pachobg2/moskvich_ignition/README.md

# moskvich_ignition — programmable ignition ECU for the Moskvich 412 / 2140

ESP32-C3 replaces the points-and-coil ignition's *switching* job while keeping
the original distributor. The points become a crank-position sensor, the ECU
fires the coil through an IGBT at a timing it looks up from an **rpm × MAP
map**, controls dwell from battery voltage, trims idle speed with spark
timing, and limits revs. Everything is tuned from a phone over the ECU's own
WiFi network — no app to install, no router needed.

> **Experimental, safety-relevant.** Wrong spark timing can wreck an engine,
> and a dead ECU means a dead engine (see *Limitations*). Bench-test with the
> simulator, verify timing with a timing light before every first start, and
> start from the conservative default map.

## How it works

```
 12 V switched ──┬── protection + buck ──► ESP32-C3 ──► gate ──► IGBT ──► coil (−)
                 │                           ▲  ▲
 distributor ────┼── pull-up + NPN ──────────┘  │ ADC
   (points)      │                              │
 MAP hose ───────┴── MPX4115-class sensor ──────┘
```

* **Trigger reference (Setup):** two choices.
  **OPEN edge (default)** — distributor locked at full advance, trigger ≈ 40°: most accurate.
  **CLOSE edge** — factory distributor (weights blocked at rest, vacuum capsule off), trigger ≈ 120°
  before the firing cylinder: the ECU predicts ~3× further ahead (use *Acceleration compensation*
  100%, which the UI sets for you), and while cranking it falls back to the OPEN edge (≈10° factory
  static timing) because 120° of prediction is far too coarse at cranking-speed variation.
  Host-simulated error: ≤0.04° steady, ~0.9° over a 1000→5500 rpm/4 s ramp, ≤0.5° on a hard
  lift-off with compensation, ≈0.3° cranking. The closing edge bounces more than the opening one:
  verify on a scope.
* **Points = sensor only.** They no longer carry coil current (no arcing, no
  condenser needed). The instant they *open* marks a fixed crank angle,
  `trigger angle` (≈ 40° BTDC).
* **The distributor's mechanical advance is locked at that angle** (weights
  blocked, vacuum capsule disconnected). The ECU can only *delay* the spark
  relative to the trigger, so any advance up to the trigger angle is
  available:
  `delay = (trigger − target advance) / 180° × time since last trigger`.
* **Dwell** is ECU-controlled and voltage-compensated: at idle/cranking the
  coil is switched on `delay − dwell` after the trigger (exact dwell); at
  higher rpm it is scheduled one cycle ahead from the measured period.
* **Timing map**: 16 rpm × 16 MAP bins, bilinear interpolation, ± idle trim,
  rev-limit retard, slew limit per spark, min/max clamps.
* **LPG**: a 12 V signal from the LPG valve (GPIO3 via divider) switches the
  timing. Two modes (LPG tab): **static offset** (petrol map + N degrees,
  default +3°; no map is shown) or a **separate LPG map** (edited on the LPG tab, with
  *Copy petrol → LPG* and an optional offset). The change is slewed in at the normal per-spark limit,
  never stepped. A *Force petrol / Force LPG* override in Setup helps testing without
  the valve connected (LPG tab).
* **Factory-derived maps (Map tab → "Ignition map")**: besides your *Custom* map there are three
  slots built from the distributor data tables of the UZAM-412 family — **P-147A**, **47.3706**,
  **P-147B** — so the engine can run on a replica of the original advance curve and you can tune from there.
  Total advance = static timing + centrifugal(rpm) + vacuum(MAP) × fade(rpm), using the data-sheet
  centrifugal points (1000–5000 rpm) and the vacuum-capsule points (mmHg). Assumptions: the static
  timing is 10° (editable, "Regenerate"); the tables are in crank degrees; vacuum = 101.3 kPa − MAP;
  the capsule's tolerance bands are used at their middle; the capsule is fed from a *ported* carburettor
  vacuum that is ~0 at idle, so the vacuum advance fades in between 900 and 1300 rpm; centrifugal advance
  starts at 600 rpm and stays at its 5000 rpm value above that. **The curves reach 50–60°**, so the
  trigger angle and *Maximum advance* must allow it (the CLOSE-edge reference at ≈120° does; a 30–40° trigger
  clips them — the app shows how many cells are clipped and hatches them). You can edit a factory slot;
  *Regenerate* restores its factory curve and *Copy to Custom* starts a tune from it.
* **Cranking** uses a fixed retarded advance below `crank rpm`.
* **Rev limiter**: retard ramp from the soft limit, spark cut above the hard limit.
* **Idle control**: PI loop that nudges timing to hold the target idle rpm
  while the throttle is closed (MAP below a threshold).
* **Ignition ISRs run at interrupt priority 3**, above WiFi, so tuning on a
  phone does not move the spark. Flash writes (saving, OTA) *do* stall them,
  so the ECU **refuses to write flash while the engine turns** — edits apply
  live and are saved when you press Save with the engine stopped, or
  automatically when it stops.
* Hardware safeguards in firmware: coil-on watchdog (9 ms) if no spark was
  scheduled, no spark without a valid period measurement, bounce rejection,
  all inputs from the web app clamped by `sanitize()`.

## Files

| File | Purpose |
|---|---|
| `moskvich_ignition.ino` | setup/loop: ADC sampling, idle PI, LED, WiFi AP, OTA |
| `ignition_core.h` | **all ignition math & scheduling** — pure C++, no Arduino; tested on a PC |
| `ecu_engine.h` | ESP32-C3 layer: GPIO ISR, two one-shot hardware timers, bench simulator |
| `ecu_store.h` | NVS persistence (checksummed) and parameter `sanitize()` |
| `ecu_web.h` | web server + JSON API |
| `web/index.html` | the tuning app (single file, no dependencies; add `?mock` to try it on a PC) |
| `web_ui.h` | generated from `web/index.html` by `python tools/embed_ui.py` |
| `test/test_core.cpp` | engine-model simulation of the real ISR logic |
| `config.h.example` | copy to `config.h`: AP/OTA passwords, pins, sensor constants (gitignored) |
| `docs/HARDWARE.md` | circuit, parts list, wiring, install & tuning procedure |
| `hardware/` | **schematic, PCB (KiCad), BOM** — through-hole, ESP32-C3-Zero, IGBT cut-out; see `hardware/README.md` |

## Build

Arduino IDE / arduino-cli, **esp32 core 3.x**, board *ESP32C3 Dev Module*
(*USB CDC On Boot: Enabled* for the SuperMini), library **ArduinoJson 7**.

```bash
arduino-cli compile --fqbn esp32:esp32:esp32c3:CDCOnBoot=cdc .
```

Copy `config.h.example` → `config.h` and set the passwords. After editing
`web/index.html` run `python tools/embed_ui.py`.

Host tests (any C++17 compiler):

```bash
c++ -O2 -std=c++17 -I. test/test_core.cpp -o test/test_core && ./test/test_core
```

## Using it

1. Join WiFi **Moskvich-ECU** (password from `config.h`); the app opens as a
   captive portal, or browse to `http://192.168.4.1`.
2. **Live** — rpm, advance, MAP, battery, dwell, 60 s chart.
3. **Map** — petrol map: tap cells, ±0.5/±1, Set, Smooth, Range select, Undo, editable axes.
   The cells around the current operating point glow while the engine runs.
4. **Setup** — trigger angle, cranking, idle, limits, dwell table, MAP sensor two-point calibration.
   **LPG** — mode, static offset or the separate LPG map, valve-signal status, override.
5. **Language** — the **БГ / EN** button in the header switches the whole interface between Bulgarian and English (remembered per browser; `?lang=bg` in the URL also works). The default follows the browser language. Translations live in the `BG` table in `web/index.html`; the firmware-upload page is bilingual.
6. **Tools** — timing-light lock, bench simulator, JSON backup/restore, reset, firmware update.

Install, wiring and the timing-light calibration procedure are in
[docs/HARDWARE.md](docs/HARDWARE.md).

## Limitations / ideas

* **No limp-home.** With advance locked at 40°, running the stock points
  circuit would kick back on starting, so there is no relay bypass. Carry a
  spare ECU or the original distributor internals.
* No cam/phase signal: cylinder-to-cylinder cam-lobe and bushing wear shows up as
  a few degrees of scatter that the ECU cannot correct. A Hall-effect or
  optical distributor conversion would use the same input (set the edge).
* No knock sensor, no coolant/air temperature correction (spare ADC pins exist).
* ISR jitter vs. WiFi has been reasoned about, not scope-measured: verify with a
  scope/timing light at 6000 rpm on the bench simulator and adjust `latency_us`.
* Idea: log a short ring buffer of rpm/MAP/advance for download after a drive.

## Version History

| Version | Date | Changes |
|---|---|---|
| 1.0.0 | 2026-10-26 | Initial release: points-trigger delay-only timing, 16×16 rpm×MAP map, voltage-compensated dwell, cranking/idle/rev-limit logic, WiFi AP web tuner (live data, map editor, setup, timing-light lock, bench simulator, backup, OTA), host-side engine-model tests. |
| 1.1.0 | 2026-10-27 | MAP sensor two-point calibration in Setup (any linear 1-bar analog sensor, e.g. GM/Lada/Bosch; capture-from-live-reading buttons); `MAP_SLOPE`/`MAP_OFFSET`/`MAP_SUPPLY_MV` removed from `config.h`. Stored settings from 1.0.0 are discarded on first boot (defaults load). |
| 1.2.0 | 2026-10-27 | LPG timing: 12 V valve-signal input (GPIO3, hysteresis + debounce), static-offset mode or separate LPG map, copy petrol → LPG (+offset), manual override, LPG badge in the UI. Settings from 1.1.0 are discarded on first boot (defaults load). |
| 1.2.1 | 2026-10-27 | UI: LPG settings moved to their own tab; the LPG map is only shown in "Separate LPG map" mode (static-offset mode shows just the offset). |
| 1.3.0 | 2026-10-27 | Setup: choice of trigger reference — points OPEN edge (distributor locked at full advance, ~40°) or points CLOSE edge (factory distributor, ~120°) with automatic OPEN-edge cranking reference; trigger angle range up to 160°; extended host tests. Settings from 1.2.x are discarded on first boot (defaults load). |
| 1.4.0 | 2026-10-27 | Web interface available in Bulgarian (БГ/EN switch, default from browser language), bilingual firmware-upload page; fix: elements marked hidden (e.g. the LPG copy button on the petrol map) were still shown. |
| 1.4.1 | 2026-10-27 | UI: hover tooltips (in both languages) on every setting and control, e.g. what Gain (P) and Gain (I) do; the web page is now stored gzip-compressed (flash use 92% -> 88%). |
| 1.5.0 | 2026-10-27 | Targets the ESP32-C3-Zero board (new PCB in `hardware/`): pins LPG 0 / MAP 1 / VBAT 3 / POINTS 4 / COIL 6, status shown on the on-board RGB LED (GPIO10). |
| 1.6.0 | 2026-10-28 | Three factory-derived petrol maps (P-147A, 47.3706, P-147B) selectable in the Map tab, built from the UZAM-412 distributor centrifugal + vacuum advance tables; regenerate / copy-to-custom; map cells may exceed the trigger angle (clipped at use, shown in the UI). Settings from 1.5.0 are discarded on first boot (defaults load). |
| 1.6.1 | 2026-10-28 | UI: switching the trigger reference to CLOSE edge now also raises Maximum advance to 60° (it was still capping the map at 38°); the "cells exceed the limit" warning names the limit that is binding (Maximum advance or Trigger angle) and where to change it. |
| 1.6.2 | 2026-10-28 | Safety: firmware updates are refused while the engine runs (a bare POST to /update no longer reboots the ECU, and ArduinoOTA is not serviced while running); /update reports OK only after a completed upload. |
