pachobg2/moskvich_ignition/hardware/netlist.csv

Net | Pins
+12V_IN | J1.2 F1.2
+3V3 | U1.3 R4.2
+5V | U1.1 J2.2 U2.1 L1.2 C3.1 C4.1 U3.9 U3.16 C9.1 R14.2
BST | U2.6 C11.1
CEXT | U3.14 C10.1
CMD | U3.2 U3.3 R10.2 R13.1
CMD_G | U1.10 R10.1
COIL_N | J1.4 Q1.2
GATE | Q1.1 R15.1 R16.1
GATE_DRV | U3.13 R15.2
GND | U1.2 J2.4 J1.3 Q1.3 U2.4 C3.2 C4.2 C1.2 C2.2 D2.2 R7.2 C6.2 D4.2 R9.2 C7.2 D5.2 R12.2 C8.2 D6.2 R3.2 D3.2 Q2.2 C5.1 U3.1 U3.8 U3.10 U3.11 R13.2 C9.2 R16.2
LPG_IN | J2.1 R6.1
LPG_S | U1.4 R6.2 R7.1 C6.1 D4.1
MAP_S | U1.5 R11.2 R12.1 C8.1 D6.1
MAP_SIG | J2.3 R11.1
POINTS_RAW | J1.1 R1.2 R2.1
PT_B | R2.2 R3.1 D3.1 Q2.1
PT_C | Q2.3 R4.1 R5.1
PT_G | U1.8 R5.2 C5.2
REXT | U3.15 R14.1 C10.2
SW | U2.5 L1.1 C11.2
VBAT_F | D1.2 F1.1 R8.1
VB_S | U1.7 R8.2 R9.1 C7.1 D5.1
VIN_P | U2.2 U2.3 C1.1 C2.1 D2.1 D1.1 R1.1
