pachobg2/moskvich_ignition/hardware/bom.csv

Qty | Refs | Value | Footprint | Description
1 | C1 | 10uF 50V | C_1210 | Capacitor 1210 X7R 10 uF 50 V
1 | C10 | 2.2uF 25V X7R | C_0805 | Capacitor 0805 X5R/X7R (22 uF >= 10 V, 2.2 uF >= 25 V)
6 | C11 C2 C6 C7 C8 C9 | 100nF | C_0603 | Capacitor 0603 X7R 50 V
2 | C3 C4 | 22uF 10V | C_0805 | Capacitor 0805 X5R/X7R (22 uF >= 10 V, 2.2 uF >= 25 V)
1 | C5 | 10nF | C_0603 | Capacitor 0603 X7R 50 V
1 | D1 | SS34 | D_SMA | Schottky SMA (pin 1 = cathode)
1 | D2 | SMBJ24A | D_SMB | TVS SMB, unidirectional (pin 1 = cathode)
1 | D3 | 1N4148W | D_SOD-123 | SOD-123 diode (pin 1 = cathode)
3 | D4 D5 D6 | BZT52C3V6 | D_SOD-123 | SOD-123 diode (pin 1 = cathode)
1 | F1 | 0.5A 32V fuse | Fuse_1206 | SMD fuse 0.5 A, rated >= 32 V (1206 / 2410), or a resettable PTC of the same footprint
3 | H1 H2 H3 | M2.5 mounting hole (6 mm standoff) | MountingHole_2.7_M2.5 | M2.5 screw + 6 mm standoff
1 | J1 | Power | TerminalBlock_P3.50_1x04 | Screw terminal 3.5 mm pitch, 4 positions, 8 A
1 | J2 | Sensors | TerminalBlock_P3.50_1x04 | Screw terminal 3.5 mm pitch, 4 positions, 8 A
1 | L1 | 4.7uH | L_4x4 | Shielded power inductor 4.7 uH, 4x4 mm, I_sat >= 2 A, DCR < 100 mOhm (check the land pattern of the part you buy)
1 | Q1 | ISL9V3040P3 | TO-220_LayDown_Cutout | Ignition IGBT ISL9V3040P3 (TO-220), laid flat on the case floor in the cut-out
1 | Q2 | BC847B | SOT-23 | NPN BC847B (1 = B, 2 = E, 3 = C)
1 | R1 | 1k 0.25W | R_1206 | Resistor 1206, 0.25 W
2 | R10 R15 | 100R | R_0603 | Resistor 0603 1 % (thick film)
4 | R11 R13 R16 R2 | 10k | R_0603 | Resistor 0603 1 % (thick film)
2 | R12 R14 | 15k | R_0603 | Resistor 0603 1 % (thick film)
1 | R4 | 4.7k | R_0603 | Resistor 0603 1 % (thick film)
1 | R5 | 1k | R_0603 | Resistor 0603 1 % (thick film)
2 | R6 R8 | 100k | R_0603 | Resistor 0603 1 % (thick film)
3 | R3 R7 R9 | 22k | R_0603 | Resistor 0603 1 % (thick film)
1 | U1 | ESP32-C3-Zero | ESP32-C3-Zero_2x9_Socket | Waveshare ESP32-C3-Zero on 2x 1x9 female headers (2.54 mm, 15.24 mm apart)
1 | U2 | AP63205WU-7 | SOT-23-6 | AP63205WU-7 (TSOT-26): 1 FB, 2 EN, 3 VIN, 4 GND, 5 SW, 6 BST
1 | U3 | CD74HCT221M96 | SOIC-16_3.9x9.9mm_P1.27mm | CD74HCT221M96 (SOIC-16 narrow; same pinout as the 74HCT123). Non-retriggerable, tW = 0.7 Rx Cx
