pachobg2/moskvich_ignition/hardware/moskvich_ecu.kicad_pcb

## KiCad design hardware/moskvich_ecu.kicad_pcb (2026-10-26)

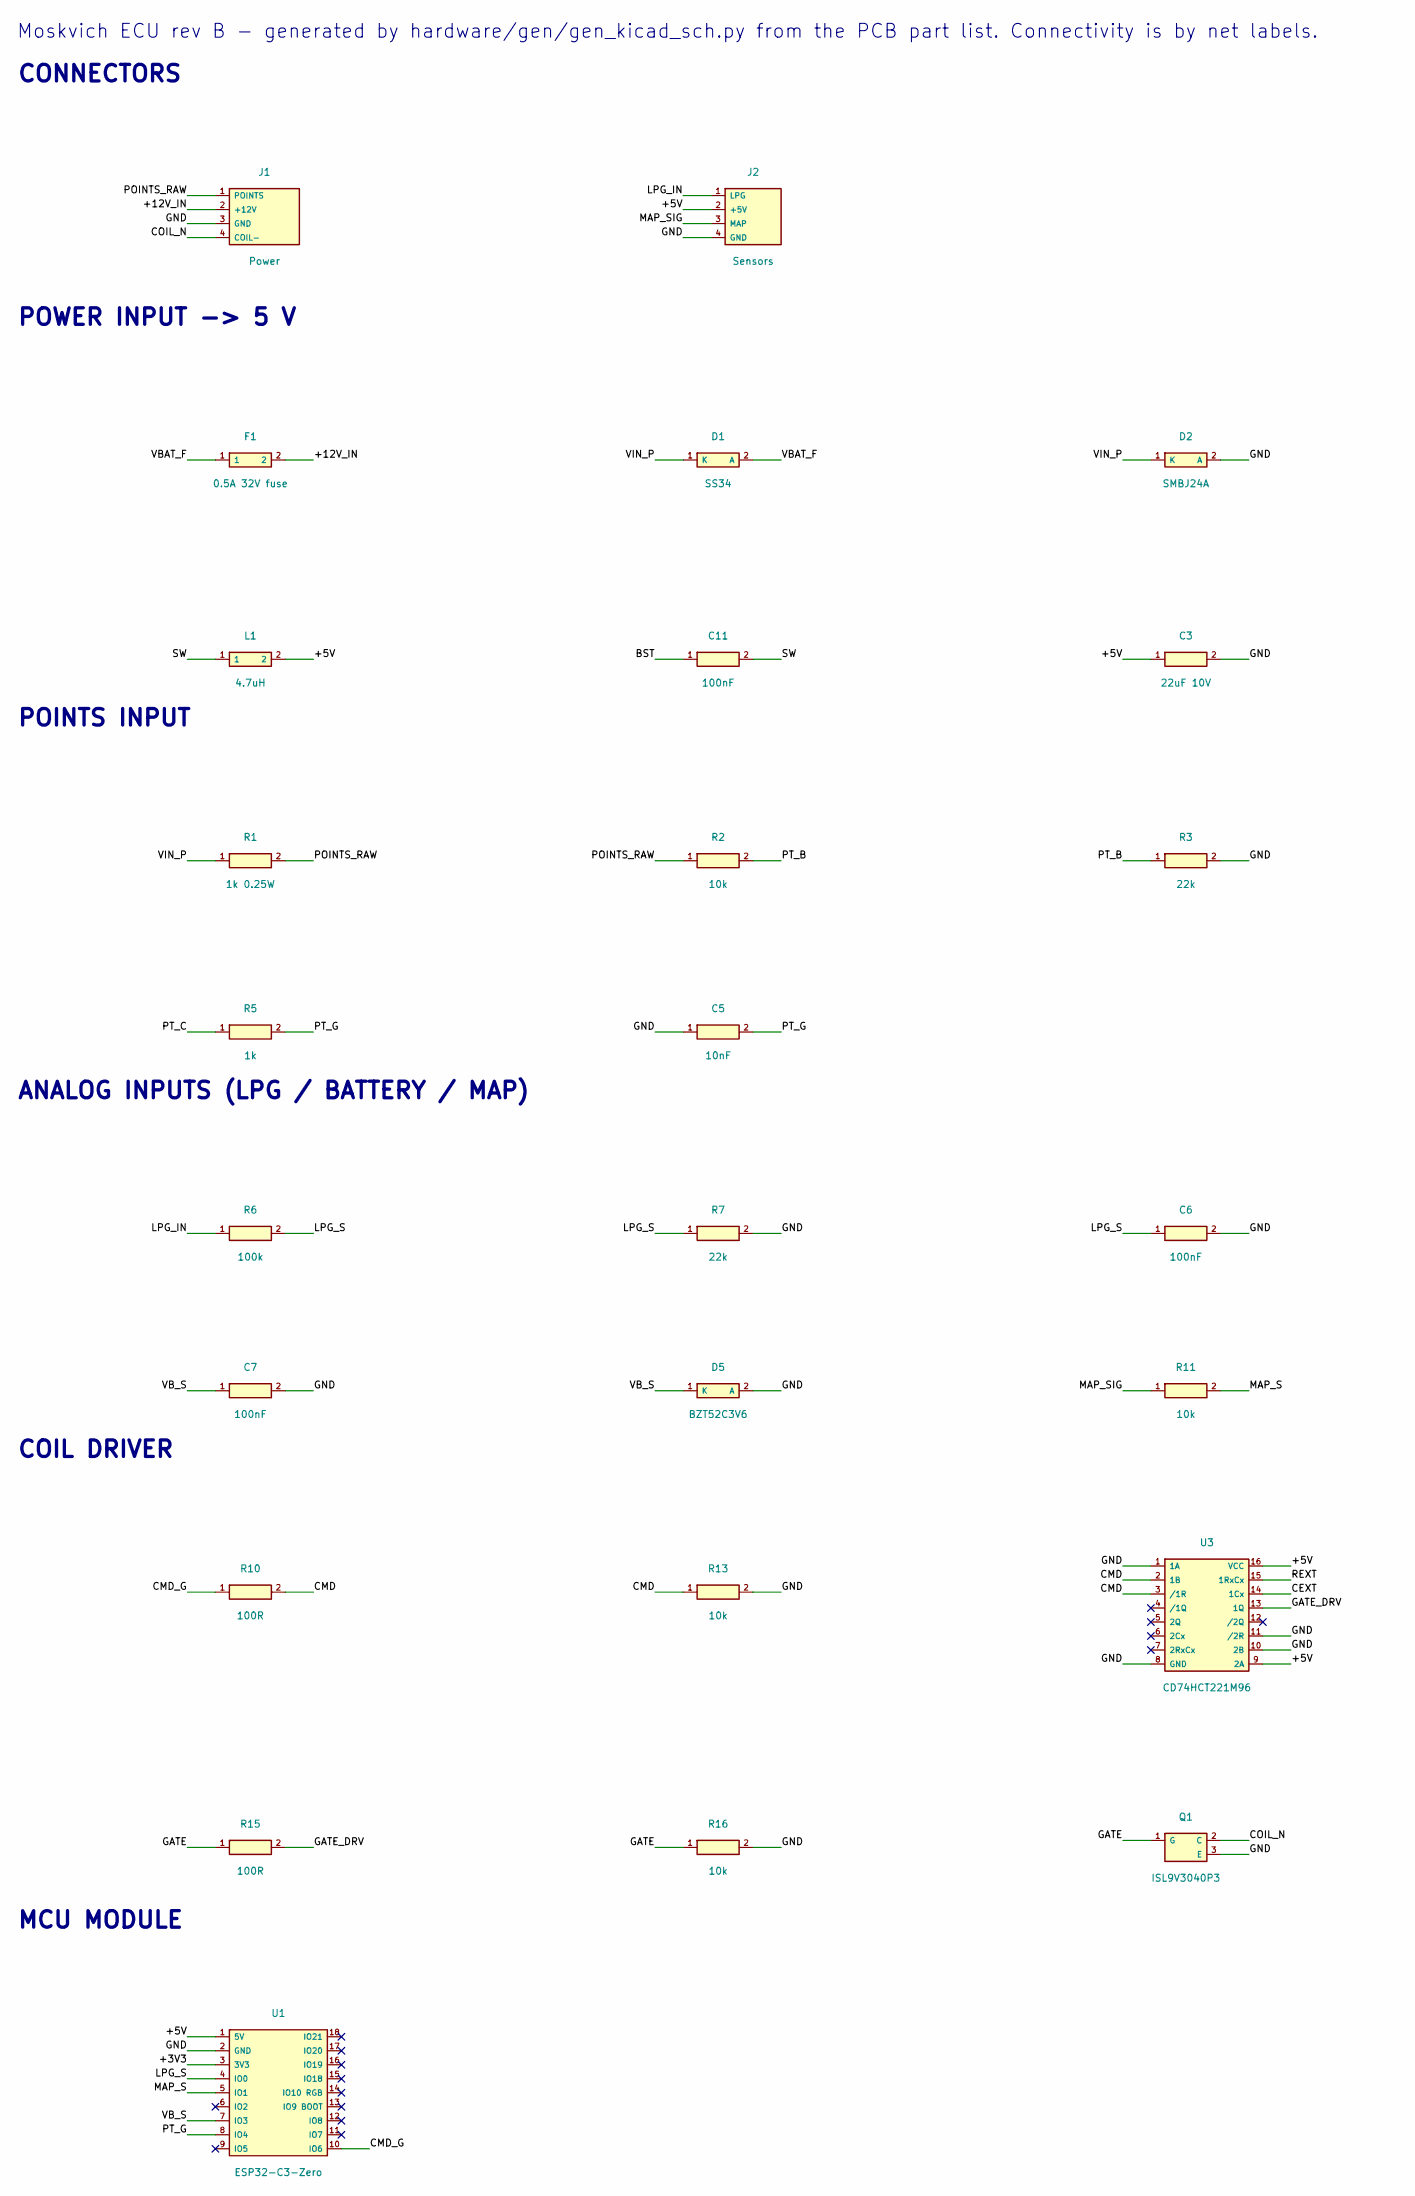
[picture p1: schematic moskvich_ecu.kicad_sch, part in row 1, column 1]

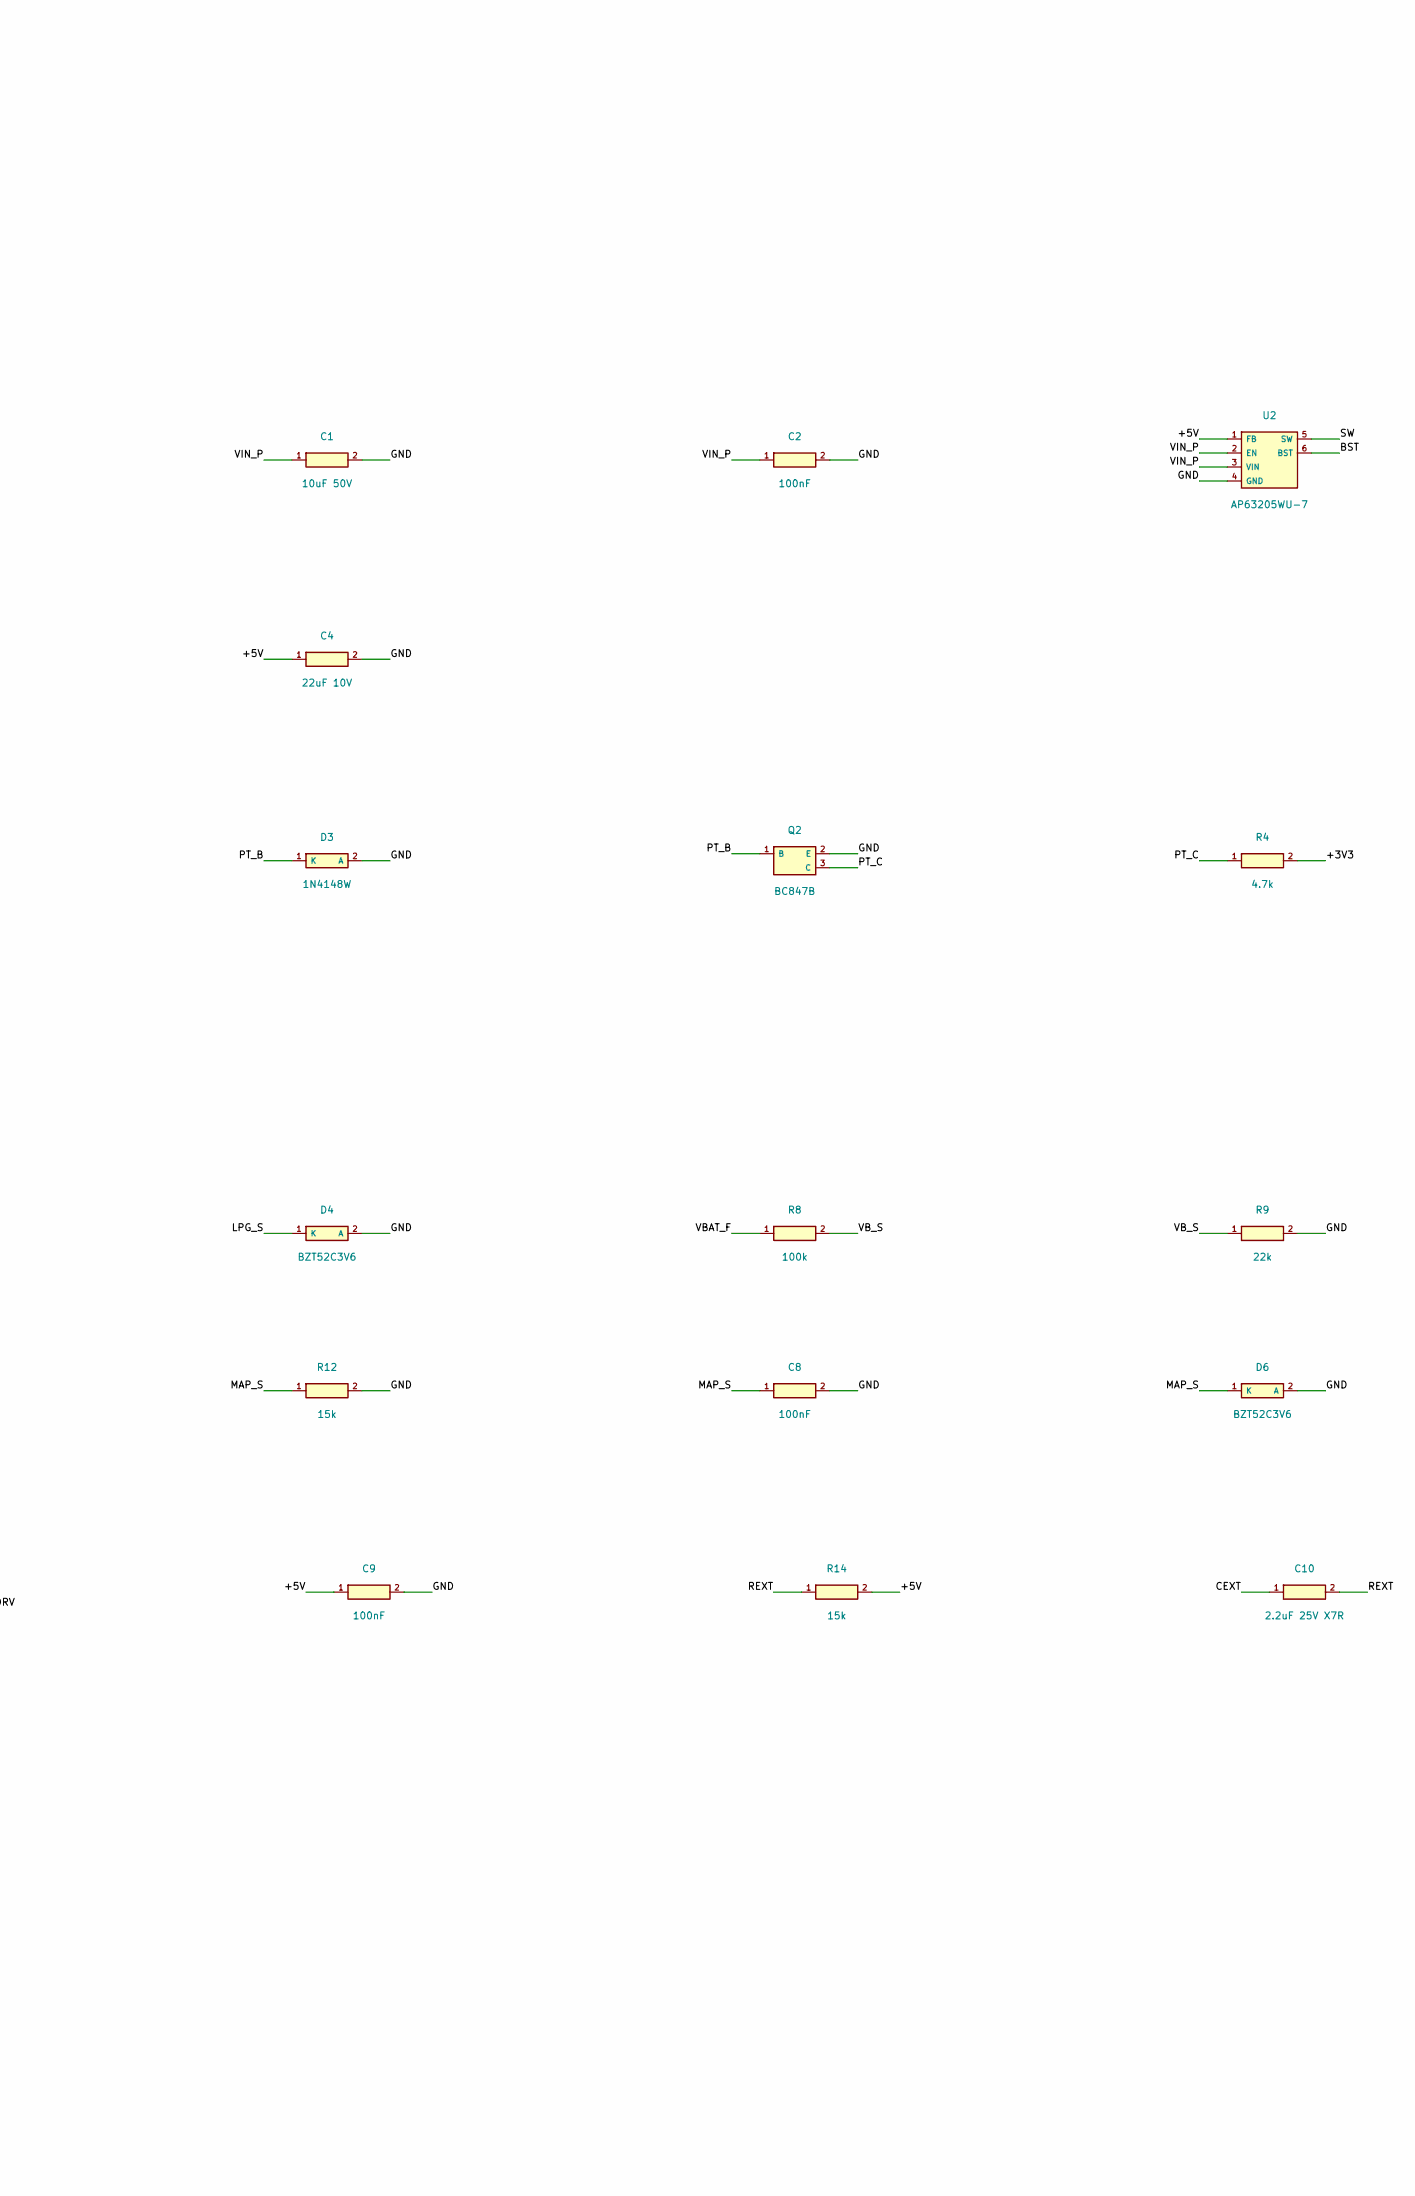
[picture p2: schematic moskvich_ecu.kicad_sch, part in row 1, column 2]

Parts:
C1: 10uF 50V; C_1210_3225Metric
C2, C6, C7, C8, C9, C11: 100nF; C_0603_1608Metric
C3, C4: 22uF 10V; C_0805_2012Metric
C5: 10nF; C_0603_1608Metric
C10: 2.2uF 25V X7R; C_0805_2012Metric
D1: SS34; D_SMA
D2: SMBJ24A; D_SMB
D3: 1N4148W; D_SOD-123
D4, D5, D6: BZT52C3V6; D_SOD-123
F1: 0.5A 32V fuse; Fuse_1206_3216Metric
J1: Power; TerminalBlock_P3.50_1x04
J2: Sensors; TerminalBlock_P3.50_1x04
L1: 4.7uH; pick your inductor)
Q1: ISL9V3040P3; TO-220_LayDown_Cutout
Q2: BC847B; SOT-23
R1: 1k 0.25W; R_1206_3216Metric
R2, R11, R13, R16: 10k; R_0603_1608Metric
R3, R7, R9: 22k; R_0603_1608Metric
R4: 4.7k; R_0603_1608Metric
R5: 1k; R_0603_1608Metric
R6, R8: 100k; R_0603_1608Metric
R10, R15: 100R; R_0603_1608Metric
R12, R14: 15k; R_0603_1608Metric
U1: ESP32-C3-Zero; ESP32-C3-Zero_2x9_Socket
U2: AP63205WU-7; SOT-23-6
U3: CD74HCT221M96; SOIC-16_3.9x9.9mm_P1.27mm

Connections:
+3V3: R4.2, U1.3 (3V3)
+5V: C3.1, C4.1, C9.1, J2.2 (+5V), L1.2, R14.2, U1.1 (5V), U2.1 (FB), U3.9 (2A), U3.16 (VCC)
+12V_IN: F1.2, J1.2 (+12V)
BST: C11.1, U2.6 (BST)
CEXT: C10.1, U3.14 (1Cx)
CMD: R10.2, R13.1, U3.2 (1B), U3.3 (/1R)
CMD_G: R10.1, U1.10 (IO6)
COIL_N: J1.4 (COIL-), Q1.2 (C)
GATE: Q1.1 (G), R15.1, R16.1
GATE_DRV: R15.2, U3.13 (1Q)
GND: C1.2, C2.2, C3.2, C4.2, C5.1, C6.2, C7.2, C8.2, C9.2, D2.2 (A), D3.2 (A), D4.2 (A), D5.2 (A), D6.2 (A), J1.3 (GND), J2.4 (GND), Q1.3 (E), Q2.2 (E), R3.2, R7.2, R9.2, R12.2, R13.2, R16.2, U1.2 (GND), U2.4 (GND), U3.1 (1A), U3.8 (GND), U3.10 (2B), U3.11 (/2R)
LPG_IN: J2.1 (LPG), R6.1
LPG_S: C6.1, D4.1 (K), R6.2, R7.1, U1.4 (IO0)
MAP_S: C8.1, D6.1 (K), R11.2, R12.1, U1.5 (IO1)
MAP_SIG: J2.3 (MAP), R11.1
POINTS_RAW: J1.1 (POINTS), R1.2, R2.1
PT_B: D3.1 (K), Q2.1 (B), R2.2, R3.1
PT_C: Q2.3 (C), R4.1, R5.1
PT_G: C5.2, R5.2, U1.8 (IO4)
REXT: C10.2, R14.1, U3.15 (1RxCx)
SW: C11.2, L1.1, U2.5 (SW)
VBAT_F: D1.2 (A), F1.1, R8.1
VB_S: C7.1, D5.1 (K), R8.2, R9.1, U1.7 (IO3)
VIN_P: C1.1, C2.1, D1.1 (K), D2.1 (K), R1.1, U2.2 (EN), U2.3 (VIN)

Notes on the sheet:
CONNECTORS
POWER INPUT -> 5 V
POINTS INPUT
ANALOG INPUTS (LPG / BATTERY / MAP)
COIL DRIVER
MCU MODULE
Moskvich ECU rev B - generated by hardware/gen/gen_kicad_sch.py from the PCB part list. Connectivity is by net labels.

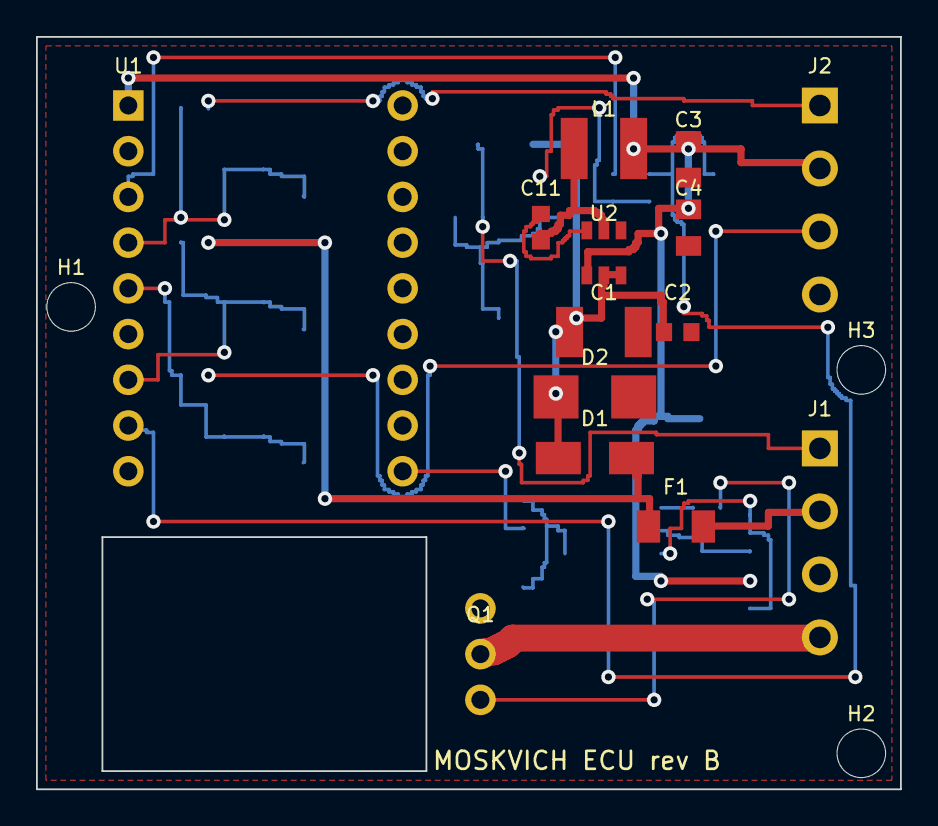
[picture p3: board moskvich_ecu.kicad_pcb from above]

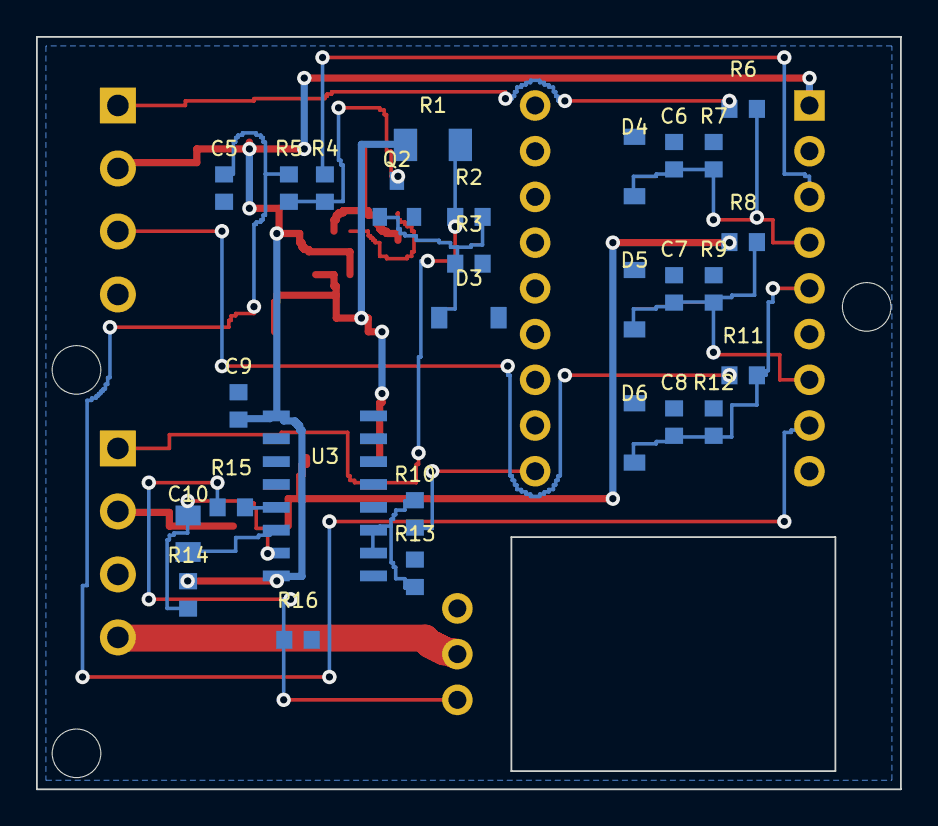
[picture p4: board moskvich_ecu.kicad_pcb from below]

Board: 2 copper layers, 48.0 x 41.8 mm, 45 parts (28 on the bottom side), 24 nets.

Other parts of the board:
H1, H2, H3: M2.5; MountingHole_2.7_M2.5
