pachobg2/moskvich_ignition/(commit log)

2026-10-26 v1.1.0: two-point MAP sensor calibration (any linear 1-bar sensor)
2026-10-26 v1.2.0: LPG timing (valve signal input, static offset or separate LPG map)
2026-10-26 v1.4.0: Bulgarian web interface (BG/EN switch), bilingual update page, fix hidden attribute
    [ecu_web.h]
2026-10-26 v1.5.0: ESP32-C3-Zero hardware — schematic, through-hole PCB with IGBT cut-out, BOM; RGB status LED
    [bom.csv, moskvich_ecu.kicad_pcb, netlist.csv]
2026-10-26 Hardware rev B: SMD two-sided board (48 x 41.8 mm), AP63205 SMD buck, SOIC/SOT parts, 3.5 mm terminals, IGBT cut-out
    [bom.csv, moskvich_ecu.kicad_pcb, netlist.csv]
2026-10-26 hardware: KiCad schematic (netlist-checked against the PCB) + project file, import notes
    [moskvich_ecu.kicad_sch]
2026-10-26 hardware: switch the coil guard to CD74HCT221M96 (same pinout, tW = 0.7 R C), R14 = 15k
    [bom.csv, moskvich_ecu.kicad_pcb, moskvich_ecu.kicad_sch]
2026-10-26 v1.6.1: switching to close-edge reference raises Max advance; clip warning names the binding limit
